ra-dhe-shyam/ATMega328P_based_ecu_for_FS_vehicle/Hardware/Readme.md

Hardware aspects, Specifications, Calculations, Schematic and PCB design of Motherboard with 2 seperate revisions.
