ra-dhe-shyam/ATMega328P_based_ecu_for_FS_vehicle/Hardware/Motherboard_Rev2/README.md

Schematic design and PCB layout for motherboard revision 2.
