ra-dhe-shyam/ATMega328P_based_ecu_for_FS_vehicle/Hardware/Motherboard_Rev1/README.md

Schematic design and PCB layout of Motherboard revision 1.
