ra-dhe-shyam/ATMega328P_based_ecu_for_FS_vehicle/(list of files, drawings)

Other design files:
Hardware/Motherboard_Rev1/PCB1.PcbDoc
Hardware/Motherboard_Rev1/Sheet1.SchDoc
Hardware/Motherboard_Rev1/Sheet2.SchDoc
Hardware/Motherboard_Rev1/Sheet3.SchDoc
Hardware/Motherboard_Rev1/Sheet4.SchDoc
Hardware/Motherboard_Rev2/Sheet1.SchDoc
Hardware/Motherboard_Rev2/Sheet2.SchDoc
Hardware/Motherboard_Rev2/Sheet3.SchDoc
Hardware/Motherboard_Rev2/Sheet4.SchDoc
Hardware/Motherboard_Rev2/Sheet5.SchDoc
